newro0209/timing_belt_joint_module/docs/views/axle_printed_closeup.png

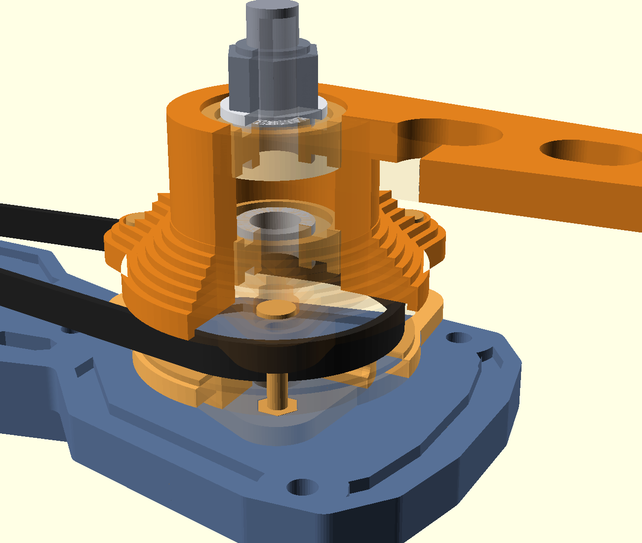
docs/views/axle_printed_closeup.png
