newro0209/timing_belt_joint_module/DESIGN.md

# 풀리 내장형 벨트 감속 관절 모듈 설계서

염가형 SCARA 로봇용 — NEMA 17 + GT2 6mm 벨트 감속 + 608ZZ 베어링 + 스트리퍼 볼트 회전축

---

## 1. 설계 개요

| 항목 | 사양 |
| --- | --- |
| 구동 모터 | NEMA 17 스테퍼, 5mm 축 |
| 입력축 풀리  | GT2 20T, 5mm bore, 6mm belt용 |
| 출력축 풀리  | GT2 60T, **8mm bore**, 6mm belt용 — Ø8 회전축에 직접 끼움 |
| 감속 방식 | GT2 2mm 피치 타이밍 벨트 1단 감속 |
| 감속비 | 3:1 |
| 회전축 | 스트리퍼 볼트, 쇼울더 Ø8 × L55 × M6 — 머리 하향, **암·풀리와 함께 회전** |
| 출력축 베어링 | 608ZZ, 8×22×7mm × 2개 — 베이스 일체 하향 보스에 **외륜 고정** |
| 스페이서 | 스케이트보드 베어링 스페이서 8×10×10mm × 1개 (내륜 사이) |
| 장력 조절 | 아이들러 없음 — 슬롯형 모터 마운트 + 잭 스크류 |
| 허브-풀리 결합 | M6 너트 축력으로 회전 적층에 통째로 클램프(마찰) + 풀리 보스 세트스크류 백업 |
| 제작 방식 | 프린팅 부품은 베이스/암 허브 2종(잭 블록은 베이스 일체), 금속 부품은 전량 기성품 무가공 사용 |

### 무가공 설계 원칙

이 설계는 드릴링·탭핑·선반 가공 없이 **3D 프린터와 일반 수공구만으로** 제작·조립할 수 있도록 다음 원칙을 따릅니다.

* 금속 기성품(모터, 풀리, 벨트, 베어링, 스트리퍼 볼트, 스페이서, 와셔, 볼트·너트류)은 구매 상태 그대로 사용하며 추가 가공을 하지 않습니다.
* 가공이 필요한 모든 형상(모터 슬롯, 보스 장공, 너트 포켓, 베어링 압입 포켓)은 3D 프린팅 부품의 형상에 미리 포함합니다.
* 프린팅 부품은 **베이스 플레이트(잭 스크류 블록 일체), 암 허브/암** 2종으로 한정합니다.
* 나사 체결은 ① 육각 너트 포켓, ② 관통 볼트 + 너트, ③ 모터 자체 탭(금속) 세 가지만 사용합니다. 플라스틱 직접 탭핑과 히트세트 인서트는 사용하지 않습니다.
* 금속 스페이서·와셔류는 3D 프린터/스케이트보드용으로 유통되는 표준품(스케이트 베어링 스페이서 8×10×10, M6/M8 평와셔, M3/M6 너트)만 사용합니다.

### 소재 절약 형상 — 3D 프린팅 ↔ CNC 공용 (2.5D)

초기 검증은 3D 프린팅으로, 이후 CNC 가공으로 전환하는 것을 전제로, 세 프린팅 부품 모두 **평면 윤곽 + 관통/단차 포켓만으로 구성된 2.5D 형상**을 유지하면서 다음과 같이 경량화했습니다. 동일 윤곽을 CNC(알루미늄/POM 판재)에서 그대로 재사용할 수 있습니다.

* **베이스 플레이트** — 직사각 통판 → **패싯(각면) 윤곽**: 45° 챔퍼 모터 패드 + 테이퍼 웨이스트 + 출력부 패싯 + 스웹트 윙(장착 귀). 상면에 패널라인 트렌치(깊이 2, 폭 3.5)와 웨이스트 헥스 벤트 2개(관통)를 넣어 강성 손실 없이 감량·스타일링. 프레임 장착홀은 모터 패드 1 + 웨이스트 1 + 윙 2의 4점.
* **웨이스트 보강** — 웨이스트 양 가장자리 하면에 보강 리브(4×6mm)를 따라 붙여 **C-채널 단면**으로 만들어 면외 굽힘 강성을 수 배 확보(윗면을 베드에 대고 출력하므로 서포트 불필요). 윤곽의 오목 꼭짓점은 R3 필렛으로 응력 집중을 완화. 알루미늄 CNC 가공 시에는 리브를 생략해도 충분합니다.
* **암** — 끝단 폭 32→18mm 테이퍼 + 관통 트러스 컷 3개(측벽 5mm 이상 유지).
* **암 허브** — 회전축 재설계로 베어링 보어·클램프 형상이 모두 빠져 Ø32×13 디스크 + 암만 남음. 베어링 하우징은 베이스 일체 하향 보스로 이동(부록 #14).

| 부품 (솔리드 기준) | 기존 | 최적화 | 절감 |
| --- | ---: | ---: | ---: |
| 베이스 플레이트 | 101.2cm³ | 60.7cm³ | −40% |
| 암 허브/암 | 32.5cm³ | 29.1cm³ | −10% |
| **합계** | **133.7cm³** | **89.8cm³** | **−33%** (PETG 솔리드 환산 170g→114g) |

(수치는 고정축 시절 기준 — 회전축 재설계로 허브가 디스크로 줄고 베이스에 보스가 더해져 합계는 더 줄었습니다.)

실제 출력 시에는 인필 30~50%를 적용하므로 사용량은 더 줄어듭니다. 단품 STL은 `scad/print_parts.scad`에서 내보냅니다.

**서포트 프리 출력** — 두 부품 모두 서포트 없이 출력되도록 형상을 맞췄습니다.

* 베이스: 윗면을 베드에. 잭 블록·**베어링 보스**·웨이스트 리브가 모두 같은 방향(하면 쪽)으로 자라고, 패널라인 트렌치는 3.5mm 브리지, 베어링 포켓 사이 웹은 1mm 링 브리지, 잭 너트 포켓은 꼭짓점-업 육각(60° 벽)이라 모두 서포트 불필요.
* 암 허브: 암 윗면을 베드에. 허브 디스크 Ø32 = 암 허브측 폭이라 오버행이 없는 평면 부품.

### 동작 원리 요약

스트리퍼 볼트를 **회전축**으로 사용합니다. 베어링 2개는 베이스 일체 하향 보스에 **외륜이 고정**되고, 볼트는 내륜을 관통해 자유롭게 회전합니다.

베이스 위로 올라온 Ø8 쇼울더에 출력 풀리(8mm bore)와 암 허브가 차례로 끼워지고, 적층 맨 위의 M6 나일록 너트를 조이면 「머리~내륜~풀리~허브~너트」 전체가 한 덩어리로 압축되어 **볼트·풀리·암이 함께 회전**합니다. NEMA 17 모터의 GT2 20T 풀리에서 벨트로 토크를 전달받습니다.

토크는 너트 축력에 의한 풀리~허브 면압 마찰로 전달되고, 풀리 보스의 세트스크류가 축을 직접 물어 백업합니다. 회전-고정 결합 부품(클램프 링, 콜릿 등)이 없으므로 벨트 z 구간의 회전체는 풀리뿐 — 어떤 회전각에서도 벨트 스팬과 간섭하지 않습니다.

### 축 방향 적층 구조 — 아래에서 위로

표준 스트리퍼 볼트의 M6 나사부는 **약 10mm로 고정**이므로, 볼트는 **머리를 아래로** 하여 베어링 보스 밑에서 위로 꽂고, **M6 너트를 적층 맨 위에서** 체결합니다. 베이스(보스)는 압축 경로에 들어가지 않습니다 — 베이스는 외륜만 잡고, 너트는 회전 적층만 조입니다.

1. **스트리퍼 볼트 머리 + 머리측 M8 평와셔 M8×15×1.6 (z −31.1~−24)** — 적층 최하단, 보스 하면 아래입니다. 머리가 와셔를 통해 하부 베어링 **내륜**을 누릅니다. 와셔 외경 15mm는 외륜(내경 Ø17.8)에 닿지 않습니다.

2. **하부 베어링 608ZZ (z −24~−17)** — 외륜은 보스 하면에서 압입, 내륜은 쇼울더와 함께 회전합니다.

3. **내륜 스페이서 — 스케이트 베어링 스페이서 8×10×10 × 1개 (z −17~−7)** — 상하 내륜 사이 간격 10mm 확보(베어링 중심 간 거리 17mm). 같은 구간의 외륜 사이에는 베이스의 내경 Ø20 웹이 있어 외륜을 양방향 축하중에 대해 받칩니다.

4. **상부 베어링 608ZZ (z −7~0)** — 외륜은 베이스 윗면에서 압입, 윗면과 면일치.

5. **중간 M8 평와셔 M8×15×1.6 (z 0~1.6)** — 상부 내륜과 풀리 사이의 다리. **생략 금지** — 없으면 풀리 보스 하면이 고정된 외륜에 닿아 관절이 잠깁니다.

6. **출력 풀리 GT2 60T, 8mm bore (z 1.6~17.3, 보스 하향)** — 쇼울더에 직접 끼워져 센터링. 보스 세트스크류(z≈4.85, 측면 접근)가 축을 물어 가고정/백업.

7. **암 허브 (z 17.3~30.3, 높이 13mm)** — Ø8.3 보어로 쇼울더에 끼워지고, 하면이 풀리 상부 플랜지를 누릅니다. 이 면압이 주 토크 경로입니다. 허브 높이 13mm가 적층 합(55.9mm)을 쇼울더(55mm)보다 길게 만들어, 너트가 쇼울더 단차가 아니라 **적층을 압축**하도록 보장합니다(심 와셔 불요 — 부록 #15).

8. **상부 광폭 평와셔 M6×22×2.0 + M6 나일록 너트 (z 30.3~38.3)** — 이 높이는 M6 나사부 구간이므로 내경 6.4의 M6 와셔를 씁니다. 외경 22mm가 너트 축력을 프린팅 허브 윗면에 넓게 분산합니다(면압 약 9MPa). 조이면 「너트 → 와셔 → 허브 → 풀리 → 중간 와셔 → 상부 내륜 → 스페이서 → 하부 내륜 → 머리측 와셔 → 머리」 순으로 **회전 적층 전체가 한 덩어리로 압축**됩니다.

베어링 예압·유격은 이 적층이 아니라 **내륜 스페이서(10mm) ↔ 외륜 웹 높이 차**로 결정됩니다(조립 순서 4 참조) — 적층 안에 조정용 심을 둘 이유가 없습니다.

#### 수지 계산 (쇼울더 L55 기준)

| 요소 | 높이 |
| --- | ----: |
| 머리측 M8 와셔 (15×1.6)  | 1.6mm |
| 하부 608ZZ 내륜 | 7mm |
| 내륜 스페이서 |  10mm |
| 상부 608ZZ 내륜 | 7mm |
| 중간 M8 와셔 (15×1.6) | 1.6mm |
| 출력 풀리 (보스 포함) | 15.7mm |
| 암 허브 |  13mm |
| 상부 M6 와셔 (22×2.0) | 2.0mm |
| **압축 적층 합계** | **57.9mm** |
| 쇼울더 길이 |  55mm |
| **클램프 여유** | **+2.9mm** |

적층 합계가 쇼울더 길이보다 **커야** 너트가 적층을 조일 수 있습니다. 여유 2.9mm는 나사부 10mm 안에서 너트(6mm)가 온전히 물리는 범위입니다(너트 z 32.3~38.3 vs 나사 29.4~39.4). 상부 와셔는 내경 6.4(M6)이므로 쇼울더 끝(z 29.4)이 허브 보어 안에 묻혀 있어야 하는데, 허브 상면(z 30.3)이 0.9mm 위에 있어 허브가 0.9mm 이상 낮게 출력되지 않는 한 만족됩니다. 압축 경로에 프린팅 허브(PETG)가 포함되므로 초기 며칠은 크리프 후 재조임을 권장합니다.

### 평면 배치 — 위에서 내려다본 구성

베이스 플레이트를 위에서 내려다보면, 한쪽에 NEMA 17 모터가, 반대쪽에 출력축(스트리퍼 볼트 + 암)이 배치되고 두 축의 중심 간 거리는 약 99mm입니다.

* **모터 측** — NEMA 17이 슬롯 4개(M3용 장공)를 통해 베이스 하면에 매달려 체결되며, 모터 축에는 GT2 20T 입력 풀리가 장착됩니다. 슬롯의 장축 방향은 두 풀리 중심을 잇는 선과 평행하므로, 모터를 슬롯 방향으로 밀고 당겨 벨트 장력을 조절할 수 있습니다.
* **잭 스크류** — 모터 **앞쪽(출력 풀리 쪽)**, 베이스 **하면**에 잭 스크류 블록이 있습니다. 모터 몸체가 베이스 아래에 매달려 있으므로 블록도 같은 높이에 있어야 하며, M3 스크류 끝이 모터 앞면을 **출력 풀리 반대쪽으로 밀어** 축간거리를 늘려 장력을 거는 구조입니다.
* **출력축 측** — 베이스의 하향 베어링 보스 안에서 스트리퍼 볼트가 회전하며, 볼트에 클램프된 GT2 60T 출력 풀리가 폐루프 GT2 벨트(6mm 폭)로 20T 입력 풀리와 연결됩니다. 암은 풀리·볼트와 한 몸으로 회전하여 베이스 바깥쪽으로 뻗어 나갑니다.

### 조립 모델 색 규약

`scad/` 조립 모델과 렌더 이미지는 **회전부를 주황 계열, 고정부를 블루/그레이 계열**로 구분합니다.

* 주황/웜(회전) — 암 허브/암, 출력 풀리, 스트리퍼 볼트, 베어링 **내륜**, 내륜 스페이서, 와셔·너트, 입력 풀리, 모터 축
* 블루/그레이(고정) — 베이스 플레이트(+베어링 보스), 베어링 **외륜**·실드, 모터 몸체, 모터 체결 볼트, 잭 스크류
* 회전 축 계통은 웜 **톤온톤**으로 세분: 너트(진함) < 축 < 내륜 < 스페이서 < 평와셔(밝음)
* 조립 렌더의 1/4 사분면은 잘라내지 않고 **반투명 고스트**로 표시합니다(부품별 투명도 차등 — 겉을 감싸는 큰 부품일수록 투명). `assembly.scad`의 `ghost_alpha` 및 `cutaway()`의 `ga` 인자로 조절.

베어링이 두 색으로 갈리는 것이 이 관절의 핵심입니다 — **내륜 계통이 너트로 압축된 회전 적층**이고, 외륜은 베이스 보스에 고정됩니다.

---

## 2. 감속비 / 풀리 치수 조합

GT2 2mm 피치 기준 피치원 지름은 다음과 같습니다.

```text
PD = 잇수 × 2 / π
```

| 항목 | 값 |
| --- | ---: |
| 입력 풀리 | GT2 20T, 5mm bore |
| 입력 풀리 PD  | 약 12.7mm |
| 출력 풀리 | GT2 60T, 8mm bore |
| 출력 풀리 PD  | 약 38.2mm |
| 감속비 | 3:1 |
| 권장 벨트 |  GT2-280mm, 6mm 폭 |
| 권장 축간거리 C | 약 99.2mm |
| 소풀리 감김각 | 약 165° |
| 소풀리 물림 잇수 | 약 9.2개 |

### 권장 조합

| 조합 | 감속비 | 모터 풀리 | 출력 풀리 | 권장 벨트 | 축간거리 C | 소풀리 감김각 / 물림 잇수 |
| --- | --: | --- | --- | --- | ---: | ---: |
| 기본 조합  | 3:1 | GT2 20T, 5mm bore | GT2 60T, 8mm bore | GT2-280-6mm |  약 99.2mm | 약 165° / 9.2개 |
| 준컴팩트 조합 | 3:1 | GT2 20T | GT2 60T | GT2-260-6mm |  약 89.1mm | 약 164° / 9.1개 |
| 컴팩트 조합 | 3:1 | GT2 20T | GT2 60T | GT2-200-6mm |  약 58.6mm | 약 155° / 8.6개 |
| 여유 조합  | 3:1 | GT2 20T | GT2 60T | GT2-300-6mm | 약 109.3mm | 약 167° / 9.3개 |

**권장값은 GT2-280-6mm 벨트 + 축간거리 약 99mm**입니다.

버전 전환은 `scad/params.scad`의 `belt_len`(200/260/280/300)으로 하며, 축간거리 C는 벨트 길이식 2C + π(D+d)/2 + (D−d)²/4C = L 의 역산으로 자동 결정됩니다. **GT2-200 컴팩트**(C≈58.6)는 베이스가 웨이스트 없는 단축 윤곽으로 전환됩니다 — 모터 패드가 윙에 직결되고, 프레임 장착홀 3점(웨이스트 홀 제외), 웨이스트 리브·헥스 벤트는 생략됩니다.

GT2-150은 **성립하지 않습니다** — C≈32.5mm가 되는데, 베이스 아래 같은 높이에 있는 NEMA 17 몸체(반폭 21.15)와 베어링 보스(반경 16)의 최소 축간거리가 약 37.2mm라 4.7mm 간섭합니다. 150급 길이가 필요하면 출력 40T(2:1, C≈44.5) 또는 소형 모터로의 변경이 전제됩니다.

슬롯 조절 범위 ±5mm를 확보하면(슬롯 길이 14mm) 벨트 길이 오차와 제작 오차를 충분히 흡수할 수 있습니다.

### 출력 토크 및 분해능

NEMA 17 홀딩토크를 0.45N·m로 가정하면 다음과 같습니다.

```text
출력 홀딩토크 ≈ 0.45 × 3 × 0.95 ≈ 1.28N·m
```

| 항목 | 값 |
| --- | ---: |
| 감속비 | 3:1 |
| 출력 홀딩토크 | 약 1.28N·m |
| 풀스텝 출력 분해능 | 1.8° / 3 = 0.6° |
| 16 마이크로스텝 기준 | 0.6° / 16 = 0.0375° |

GT2 6mm 벨트와 3:1 감속 구조는 **소형 SCARA의 팔꿈치 J2, 손목축, 경량 어깨축**에 적합합니다. 어깨 J1처럼 큰 모멘트를 받는 축에는 벨트 폭 9mm 이상 또는 2단 감속을 검토하는 편이 좋습니다.

---

## 3. 슬롯형 모터 고정 구조

### 구조

베이스 플레이트를 3D 프린팅하며, 다음 형상을 모두 프린팅 형상에 포함합니다. 후가공은 하지 않습니다. 잭 블록이 베이스 하면에 돌출되므로 **베이스는 윗면을 베드에 대고** 프린팅하면 서포트가 필요 없습니다.

모든 슬롯의 장축 방향은 **두 풀리 중심을 잇는 선과 평행**해야 합니다.

1. **모터 체결 슬롯 4개**

   * M3 볼트용
   * 폭 3.4mm
   * 길이 14mm (조절 범위 ±5.3mm)
   * NEMA 17의 31mm 정사각 체결 패턴 기준

2. **센터 보스 장공 1개**

   * NEMA 17 전면 Ø22 위치결정 보스용
   * 폭 22.5mm
   * 길이 34.5mm 오벌 형상

3. **잭 스크류 블록 (베이스 일체)**

   * 모터 **앞쪽(출력 풀리 쪽)**, **베이스 하면**에 배치 — 모터 몸체가 베이스 아래에 매달리므로 미는 지점도 베이스 아래(스크류 축 약 z−15mm)에 있어야 합니다.
   * 프린팅 블록에 M3 육각 너트 포켓을 몰드-인 — 포켓은 모터 쪽(−x) 면에 두어, 스크류가 모터를 밀 때 너트가 블록 살에 받쳐지게 합니다.
   * M3×20 스크류 끝이 모터 앞면을 출력 풀리 반대쪽으로 밀도록 설계. 머리는 출력축 쪽을 향하므로 베이스 아래 공간에서 드라이버로 돌립니다.

### 장력 조절 절차

1. 모터 체결 볼트 4개를 살짝만 조인 상태로 벨트를 겁니다.
2. 잭 스크류를 돌려 모터를 출력 풀리 반대쪽으로 밀어 장력을 겁니다.
3. 장력을 확인한 뒤 모터 볼트 4개를 대각선 순서로 본조임합니다.
4. 잭 스크류는 그대로 두어 장력 저하 방지 스토퍼로 사용합니다.

### 적정 장력 기준

* 스팬 중앙을 손가락으로 눌렀을 때 **벨트 폭 정도, 즉 약 5~6mm 처짐**이면 적정입니다.
* GT2 6mm 벨트는 과장력을 주지 않는 것이 중요합니다.
* 백래시 제거에 필요한 최소 장력만 주는 방향이 좋습니다.
* NEMA 17 축에 불필요한 레이디얼 하중이 걸리지 않도록 편측 장력은 보수적으로 관리합니다.

---

## 4. 회전축 — Ø8 스트리퍼 볼트 + 608ZZ 베어링 구조

### 부품 선정

| 항목 | 규격 | 비고 |
| --- | --- | --- |
| 스트리퍼 볼트 | 쇼울더 Ø8 × L55 × M6 (나사부 10mm) | 국내명 쇼울더볼트 또는 스트리퍼볼트, 머리 하향 — **회전축으로 사용** |
| 베어링 | 608ZZ, 8×22×7mm × 2 | 구하기 쉬운 표준 베어링(스케이트보드용), 외륜을 베이스 보스에 압입 |
| 스페이서 | 스케이트 베어링 스페이서 8×10×10mm × 1 | 내륜 사이, 스케이트보드 표준품 |
| 평와셔 | M8×15×1.6 × 2, M6×22×2.0 × 1 | 머리측·중간(M8, 외륜 간섭 금지) + 상부 광폭(M6, 허브 면압 분산) |
| 너트 | M6 나일록 너트 × 1 | 적층 상단 체결 (회전 적층 전체를 클램프) |

(이전의 고정축 구조와 `hub_mount` 콜릿/세트스크류 결합 변형은 회전축 재설계로 제거했습니다 — git 히스토리 참조. 변형 분기 없는 단일 구조입니다.)

### 회전 원리

* 베이스의 **하향 베어링 보스**(Ø32, z −25~−8)에 608ZZ 2개의 **외륜**을 압입합니다 — 상부는 베이스 판 두께 안(z −7~0), 하부는 보스 안(z −24~−17), 사이의 내경 Ø20 웹이 외륜을 양방향 축하중에 대해 받칩니다.
* 스트리퍼 볼트는 **머리를 아래로** 하여 보스 밑에서 위로 꽂습니다. Ø8 쇼울더가 두 베어링 내륜을 지나 베이스 위로 올라오고, 풀리(8mm bore)와 허브가 쇼울더에 차례로 끼워집니다.
* 위쪽 M6 나사부(10mm)에 광폭 M6 와셔(22×2.0)를 끼우고 M6 나일록 너트로 본조임하면, 「머리 → 와셔 → 하부 내륜 → 스페이서 → 상부 내륜 → 와셔 → 풀리 → 허브 → 와셔 → 너트」 가 한 덩어리로 압축되어 **볼트·내륜·풀리·허브·암 전체가 함께 회전**합니다.
* 토크는 너트 축력에 의한 면압 마찰(풀리 상부 플랜지 ↔ 허브 하면)로 전달되고, 풀리 보스의 **세트스크류가 Ø8 축을 직접 물어** 백업 + 조립 가고정을 겸합니다.

### 베이스 베어링 포켓 설계

| 항목 | 권장값 |
| --- | ---: |
| 베어링 외경 | 22mm |
| 프린팅 포켓 — 후가공 없음 | 21.8~22.0mm, 공차 시험편으로 프린터별 보정 |
| 최종 압입 목표 | 약 22.0mm 근처 |
| 외륜 웹 내경 | 20mm |
| 베어링 간 중심 거리 | 내륜 스페이서 10mm + 7mm = 17mm |

**압입 방향:** 상부 베어링은 베이스 윗면에서 아래로(웹 상면 z −7에 닿을 때까지), 하부 베어링은 보스 하면에서 위로(웹 하면 z −17) 압입합니다. 내륜 스페이서는 두 베어링을 넣기 **전에** 웹 안쪽에 넣어 둡니다(웹 내경 Ø20 < 베어링 외경이므로 나중에 넣을 수 없습니다).

---

## 5. 출력 풀리 ↔ 암 결합 — 회전 적층 클램프

출력 풀리는 **GT2 60T, 8mm bore, 6mm belt용** 기성품을 **무가공 그대로** 사용합니다. 8mm bore가 Ø8 쇼울더에 직접 끼워져 센터링되므로, 별도 결합 부품이 필요 없습니다.

### 왜 회전축인가 — 결합 부품의 소거

고정축 구조에서는 "회전하는 풀리·허브"를 "회전하는 베어링 외륜"에 묶기 위한 결합 수단(클램프 링, 콜릿 슬리브, 핀치 볼트 등)이 반드시 필요했고, 그 결합부가 벨트 스팬과의 간섭(부록 #13)이나 부품 수 증가를 낳았습니다.

축 자체가 회전하면 결합 문제가 통째로 사라집니다 — 회전해야 하는 모든 부품(내륜·풀리·허브)을 **스트리퍼 볼트의 머리~너트 사이에 축 방향으로 한 번에 클램프**하면 끝입니다. 베어링은 베이스 일체 하향 보스에 들어가 정통적인 "회전축 + 고정 하우징" 배치가 되고, 내륜 회전·외륜 고정이라는 베어링 본래 사용법과도 일치합니다.

* **삭제된 부품**: 스탠드오프 스페이서 ×2, 클램프 링/콜릿 체결구 일체, 허브의 베어링 보어·슬리브, 심 와셔(부록 #15)
* **변경**: 출력 풀리 bore 12 → **8mm**(더 흔한 규격), 평와셔 2 → 3개(위치별 규격)
* **허브**: 베어링 없는 단순 디스크(Ø32×13) + 암 — 가장 만들기 쉬운 형태

### 토크 전달

1. **주경로 — 면압 마찰**: M6 너트 축력(약 3kN)이 「허브 하면 ↔ 풀리 상부 플랜지」 면을 누릅니다. 마찰 토크는 출력 홀딩토크 1.3N·m 대비 수 배 여유입니다.
2. **백업 — 보스 세트스크류**: 풀리 보스(하향, z 1.6~8.1, 측면 접근 가능)의 세트스크류가 Ø8 쇼울더를 직접 뭅니다. 조립 중 가고정을 겸하며, 쇼울더 표면이 경질이므로 나사고정제 병용을 권장합니다.
3. 벨트 z 구간(9.7~15.7)의 회전체는 풀리뿐(반경 ≤22), 베이스 위 고정물은 없음 — **가동 범위 360°, 벨트 간섭 원천 차단**.

### 대안 — 풀리 웹 드릴링 직결 (드릴 가공이 가능한 환경에서만)

GT2 60T 풀리의 웹에 M3 관통홀을 뚫어 허브에 볼트 직결하면 마찰 의존을 없앨 수 있으나, 금속 드릴링이 필요하므로 무가공 원칙을 지키는 본 설계에서는 채택하지 않습니다. 미끄럼이 관측되면 먼저 너트 토크를 점검하고, 그래도 부족할 때 검토합니다.

---

## 6. 부품 리스트 — 관절 1개 기준

| #  | 부품 | 규격 |  수량 | 비고 |
| -- | --- | ---: | --: | --- |
| 1  | 스테퍼 모터 | NEMA 17, 5mm 축 | 1 | 17HS4401 등  |
| 2  | 입력 풀리 | GT2 20T, 5mm bore, 6mm belt용 | 1 | 플랜지 포함 권장 |
| 3  | 출력 풀리 | GT2 60T, **8mm bore**, 6mm belt용 | 1 | Ø8 쇼울더에 직접 끼움, 무가공, 보스 하향 |
| 4  | 타이밍 벨트 | GT2 폐루프, 6mm 폭, 280mm 권장 | 1 | 축간거리 약 99mm |
| 5  | 스트리퍼 볼트 | 쇼울더 Ø8 × L55 × M6(나사부 10mm) | 1 | **회전축**, 머리 하향  |
| 6  | 베어링 | 608ZZ, 8×22×7mm | 2 | 베이스 보스에 외륜 압입, 상하 배치 |
| 7  | 내륜 스페이서 | 스케이트 베어링 스페이서 8×10×10 | 1 | 스케이트보드 표준품  |
| 8  | — (결번) |  |  | 스탠드오프 폐지 — 회전축 재설계 (부록 #14) |
| 9  | — (결번) | | | 심 와셔 폐지 — 허브 13mm 증육 + 광폭 와셔 (부록 #15) |
| 10 | 평와셔 |  M8×15×1.6 ×2 + M6×22×2.0 ×1 | 3 | 머리측·중간(M8, 외륜 간섭 금지) + 상부 광폭(M6) |
| 11 | 모터 체결 볼트 | M3×12 캡볼트 + M3 대형와셔 | 4 | 베이스 8 + 와셔 1 통과 후 모터 탭 3mm 물림 |
| 12 | — (결번) |  |  | 클램프 계통 폐지 — 회전축 재설계 (부록 #13·14) |
| 13 | M3 육각 너트 | M3 | 1 | 잭 블록 포켓 |
| 14 | 잭 스크류 | M3×20 | 1 | 너트는 #13에 포함  |
| 15 | 베이스 플레이트 | PETG/ABS/ASA 프린팅, 8mm 이상 | 1 | 슬롯·장공·잭 블록·**베어링 보스**·너트 포켓 일체 |
| 16 | 암 허브/암 | 프린팅, Ø32 디스크 + 암, Ø8.3 보어 | 1 | 회전 적층에 클램프 |
| 17 | — (결번) |  |  | 클램프 링 폐지 (부록 #13) |
| 18 | M6 나일록 너트  | M6 | 1 | 적층 상단 체결 — 회전 적층 전체를 클램프 (와셔는 #10) |

---

## 7. 조립 순서

1. **베이스 준비 + 베어링 압입**

   * 베어링 보스(하향)·포켓, NEMA 17 모터 슬롯, Ø22 보스 장공, 하면 잭 블록 + 너트 포켓, 프레임 장착홀을 모두 형상에 포함하여 베이스를 프린팅합니다(윗면을 베드에).
   * 후가공 없이 서포트 제거와 구멍 정리만 합니다. 잭 스크류용 M3 너트를 블록 포켓에 삽입합니다.
   * **내륜 스페이서를 웹 안에 먼저 넣고**, 상부 608ZZ는 베이스 윗면에서, 하부 608ZZ는 보스 하면에서 각각 웹에 닿을 때까지 압입합니다(외륜만 누를 것).

2. **모터 장착 + 모터 풀리**

   * 모터를 베이스 아래에 대고 M3×12 볼트 + 대형 와셔 4개로 살짝만 체결합니다(슬롯 중앙 부근).
   * GT2 20T 풀리를 보스가 아래로 가게 모터 축에 끼우고, 세트스크류 하나가 D컷 면을 누르도록 배치합니다. 높이는 출력 풀리와 벨트 중심이 맞도록(이빨부가 베이스 윗면 기준 약 8.9~16.5mm) 조정합니다.

3. **회전축 적층 조립**

   * 스트리퍼 볼트에 머리측 M8 와셔를 끼우고 **보스 하면에서 위로** 꽂습니다. 내륜 스페이서 구멍이 어긋나 걸리면 축을 살짝 돌려 정렬합니다.
   * 베이스 위로 올라온 쇼울더에 중간 M8 와셔를 끼웁니다.
   * 출력 풀리(8mm bore, 보스 아래로)를 쇼울더에 끼우고, **벨트를 풀리에 미리 걸쳐 둡니다**(폐루프 벨트는 암 장착 후 넘겨 끼울 수 없습니다). 보스 세트스크류를 살짝만 조여 가고정합니다.
   * 암 허브를 쇼울더에 끼우고, 광폭 M6 와셔(22×2.0)를 올린 뒤 M6 나일록 너트로 본조임합니다 — 이 축력이 내륜·풀리·허브를 한 덩어리로 묶습니다.
   * 마지막으로 보스 세트스크류를 본조임합니다(나사고정제 권장).

4. **회전 확인**

   * 암이 걸림 없이 부드럽게 회전하는지 확인합니다.
   * 뻑뻑하면 내륜 스페이서(10mm)와 외륜 웹의 높이 불일치로 베어링에 과예압이 걸린 상태입니다 — 웹을 9.8mm 수준으로 살짝 낮게 프린팅해 미세 유격 쪽으로 맞춥니다.
   * 암이 축째로 덜렁거리면 너트 본조임이 덜 된 것입니다 — 허브 상면이 쇼울더 끝(z 29.4)보다 위에 있는지(허브 높이 수지 +0.9mm) 확인하고 다시 조입니다. 암만 헛돌면 허브~풀리 면압 부족이므로 너트 토크를 올립니다.

5. **벨트 장력 조절**

   * 잭 스크류를 돌려 모터를 출력 풀리 반대쪽으로 밀어 장력을 줍니다.
   * 모터 고정 볼트 4개를 대각선 순서로 본조임합니다.

6. **벨트 트래킹 확인**

   * 저속 왕복 구동하면서 벨트가 한쪽 플랜지로 과하게 쏠리지 않는지 확인합니다.
   * 쏠림이 있으면 모터 풀리 높이, 모터 마운트 직각도를 수정합니다.

---

## 8. 설계 시 주의사항

1. **출력 풀리 세트스크류는 이제 축을 물어야 함**

   * 이 구조에서 Ø8 스트리퍼 볼트는 풀리·허브와 **함께 회전하는 축**입니다. 세트스크류가 축을 물어도 관절이 잠기지 않습니다 — 오히려 토크 백업 + 조립 가고정으로 **사용합니다**.
   * 쇼울더 표면이 매끈하고 경질이라 세트스크류 단독 그립은 약합니다. 주 토크 경로는 너트 축력 면압이며, 세트스크류에는 나사고정제를 권장합니다.

2. **풀리 bore는 8mm — 축에 직접 끼움**

   * 8mm bore가 Ø8 쇼울더에 슬라이드 끼움되어 풀리 센터링을 겸합니다.
   * 12mm bore 풀리를 쓰면 센터링이 사라지므로 사용하지 않습니다(8mm bore가 시판 60T의 가장 흔한 규격입니다).

3. **스트리퍼 볼트 방향과 나사 길이**

   * 표준 쇼울더볼트의 M6 나사부는 약 10mm 고정입니다. 회전 적층 합계(약 57.9mm)가 쇼울더(55mm)를 넘어야 너트가 적층을 압축합니다 — 허브 13mm 증육이 이 수지(+0.9mm, 와셔 포함 +2.9mm)를 만듭니다. 머리 하향 + 상단 너트 배치를 유지합니다.
   * 머리측·중간 M8 와셔는 수지 계산에 포함되므로 생략 금지. 특히 **중간 와셔(상부 내륜~풀리 사이)** 가 없으면 풀리 보스 하면이 고정된 외륜에 닿아 관절이 잠깁니다.
   * 상부 와셔는 광폭 M6×22×2.0을 사용합니다 — 외경이 작은 와셔(또는 심)를 쓰면 너트 축력이 좁은 면적으로 프린팅 허브를 파고들어 크리프로 예압이 빠집니다(부록 #15).

4. **베어링 압입 방향 (베이스 보스)**

   * 상부 포켓은 베이스 윗면으로, 하부 포켓은 보스 하면으로 개방되어 있습니다. 양쪽이 모두 막힌 포켓은 조립이 불가능하므로, 베이스 형상 수정 시 주의합니다.
   * 내륜 스페이서는 베어링 압입 **전에** 웹 안에 넣습니다(웹 내경 Ø20 < 베어링 외경).

5. **608ZZ는 구하기 쉽지만 정밀 관절용 베어링은 아님**

   * 경량 SCARA에는 사용할 수 있으나, 긴 암과 큰 하중에는 베어링 간격을 충분히 확보해야 합니다. 본 설계의 베어링 중심 간 거리는 17mm입니다.

6. **GT2 6mm 벨트의 한계**

   * 6mm 벨트는 소형·경량 구조에 적합합니다.
   * 어깨축처럼 큰 토크와 모멘트가 걸리는 곳에는 9mm 이상 벨트 또는 2단 감속이 유리합니다.

7. **벨트 평면 일치**

   * 입력 풀리와 출력 풀리의 벨트 중심 높이 차는 0.5mm 이내로 맞추는 것이 좋습니다(본 설계 기준 벨트 구간 z 9.7~15.7mm).
   * 20T 풀리 이빨부 상단(z≈16.5)이 모터 축 끝(축 길이 22mm 기준 z≈14) 위로 약간 나오지만, 풀리 강성으로 문제없습니다. 축이 짧은 모터는 풀리를 끝까지 올려 장착합니다.

8. **3D 프린팅 크리프**

   * 모터 슬롯부에는 반드시 대형 와셔를 사용합니다.
   * PLA보다는 PETG, ABS, ASA를 권장합니다.
   * 모터 마운트 주변은 두께 8mm 이상, 인필 50% 이상으로 프린팅하여 크리프에 의한 장력 저하를 줄입니다.
   * 잭 스크류를 장력 스토퍼로 남겨 두면 슬롯부 크리프가 생겨도 장력이 유지됩니다.

9. **벨트는 분해 없이 교체 불가**

   * 폐루프 벨트는 암을 넘어 끼울 수 없으므로, 교체 시 M6 너트를 풀고 암 허브만 들어냅니다(베어링·축은 그대로 — 고정축 구조보다 간단, 약 2~3분 작업).

---

## 9. 다음 단계 제안

* [ ] 608ZZ 베이스 포켓 압입 공차 시험편 출력 (Ø21.8/21.9/22.0)
* [ ] 외륜 웹 높이 보정 — 내륜 스페이서 10mm 대비 9.8mm 수준으로 미세 유격 확인
* [ ] 너트 토크 ↔ 허브-풀리 미끄럼 시험 (크리프 후 재조임 포함)
* [ ] 8mm bore 60T 풀리의 보스 치수·세트스크류 규격 실측 확인
* [ ] 쇼울더 L55 수급 확인, 불가 시 부분나사 M8×60 대안 검증
* [ ] J1 적용 시 벨트 폭 9mm 이상 또는 2단 감속 구조 검토
* [ ] CNC 전환: 동일 2.5D 윤곽으로 알루미늄/POM 판재 가공 (베이스 t8), 베어링 포켓은 리머 H7 공차로 격상

---

## 부록 — 검증에서 발견되어 수정된 문제 (2026-06)

| # | 문제 | 수정 |
| - | ---- | ---- |
| 1 | 표준 쇼울더볼트 M6 나사부는 10mm뿐이라, 머리 상향 배치로는 베이스 아래로 나사가 0.6~2mm만 나와 너트 체결 불가 | 머리 하향 + 상단 M6 나일록 체결로 반전, 쇼울더 L55 + 수지 계산표 추가 |
| 2 | 허브 상부 베어링 보어가 위(Ø20 립)·아래(Ø20 웹) 모두 막혀 있어 베어링 삽입 불가 | 상부 보어를 허브 윗면까지 개방, 압입 방향 명기 |
| 3 | 실물 GT2 60T의 세트스크류 보스(Ø32×6.5, 전체 높이 ~16mm)가 반영되지 않아 평판 샌드위치 전제가 깨지고, 모델상 풀리가 허브 본체와 체적 간섭 | 풀리를 보스 하향으로 허브 아래에 배치, 적층을 재설계(스탠드오프 20mm) |
| 4 | Ø10 센터링 보스는 벽 두께 0.7mm로 프린팅 불가·강도 없음 | 허브 하면 Ø44.6 플랜지 받이 포켓으로 센터링 방식 변경, bore 10→12mm(스페이서 통과) |
| 5 | 잭 스크류가 모터 뒤에서 +x로 밀어 축간거리가 줄어드는(벨트가 풀리는) 방향이었고, 높이도 베이스 위(z+7)라 베이스 아래에 매달린 모터(z−8~−48)에 닿지 않음 | 블록을 모터 앞쪽·베이스 하면(z−15)으로 이동, 미는 방향을 출력 풀리 반대쪽으로 수정 |
| 6 | 모터 볼트 M3×8은 베이스 8mm + 와셔 1mm를 통과하면 모터 탭에 전혀 물리지 않음 | M3×12로 변경(물림 약 3mm) |
| 7 | 클램프 체결에 히트세트 인서트와 너트가 동일 볼트에 중복 지정, 허브 플랜지 2.2mm는 인서트 길이(4mm)를 수용 불가 | 인서트 폐기, 클램프 링 윗면 너트 포켓 방식으로 단일화, 플랜지 4mm로 증육 |
| 8 | 베이스 축 구멍 Ø6.5는 Ø8 쇼울더 통과 불가(모델상 0.75mm 간섭) | Ø8.3으로 확대 — 축 위치 결정 겸용 |
| 9 | 스페이서 "외경 10~12, 길이 8~10"은 비표준 치수 조합 | 스케이트 베어링 스페이서 8×10×10 표준품 3개로 통일 |
| 10 | 슬롯 길이 12mm는 문서의 ±5mm 조절 범위와 불일치(±4.3mm) | 슬롯 14mm로 연장 |
| 11 | 60T 이빨 외경 40.4mm는 과대(실제 PD 38.2 − 0.5 ≈ 37.7) | 37.7mm로 수정, 벨트 경로 동기화 |
| 12 | 베이스에 프레임 장착 수단 없음 | 모서리 M4 관통홀 4개 추가 |
| 13 | 클램프 볼트(PCD50, 반경 23.5~26.5)가 벨트 직선 스팬(수직거리 18.85~20.35)을 벨트 높이에서 가로질러, 회전 약 ±36° 이후 충돌 — 가동 범위 치명 제한 | 풀리를 보스 상향으로 반전, 허브 슬리브 직결(`hub_mount` 콜릿/세트스크류 2변형)로 1차 재설계, 클램프 링·PCD50 볼트 폐지 |
| 14 | 고정축 구조에서는 회전부-외륜 결합 부품(슬리브·콜릿·체결구)이 필수이고 풀리가 허브에 캔틸레버로 매달림 | **회전축 구조로 전면 재설계** — 베어링 외륜을 베이스 일체 하향 보스에 고정, 볼트+내륜+풀리(8mm bore)+허브를 M6 너트 축력으로 통째 클램프. 스탠드오프 ×2·결합 변형 일체 삭제, 허브는 Ø32 디스크로 단순화, 가동 360° 유지 |
| 15 | 심 와셔(Ø14)가 너트 축력을 평와셔(Ø16)보다 좁은 면적으로 프린팅 허브에 전달 — 전단 가공 모서리가 수지면을 파고들어 크리프·예압 손실. 심은 직렬 적층이라 베어링 예압 조정 기능도 실제로는 없음(예압은 스페이서↔웹 높이 차로 결정) | 심 와셔 폐지 — 허브 12→13mm 증육으로 「적층 > 쇼울더」 수지를 형상으로 보장(+0.9mm), 상부 와셔를 광폭 M6×22×2.0으로 변경해 허브 면압 약 30→9MPa로 저감. 평와셔는 위치별 기성품(M8×15×1.6 ×2 + M6×22×2.0 ×1)으로 확정 |
