newro0209/timing_belt_joint_module/docs/views/axle_collar.png

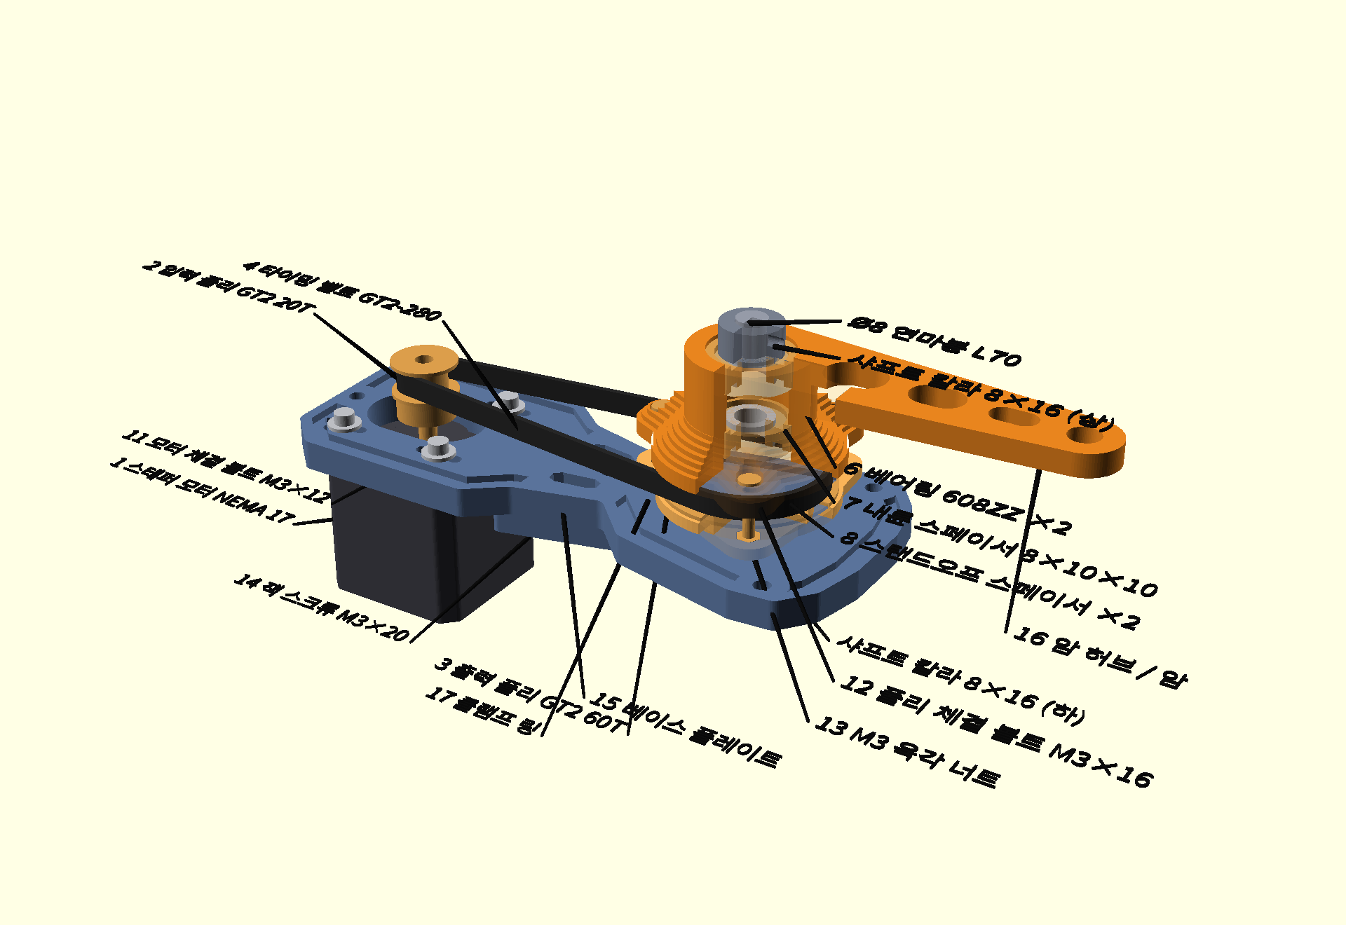
docs/views/axle_collar.png
