newro0209/timing_belt_joint_module/docs/views/bottom.png

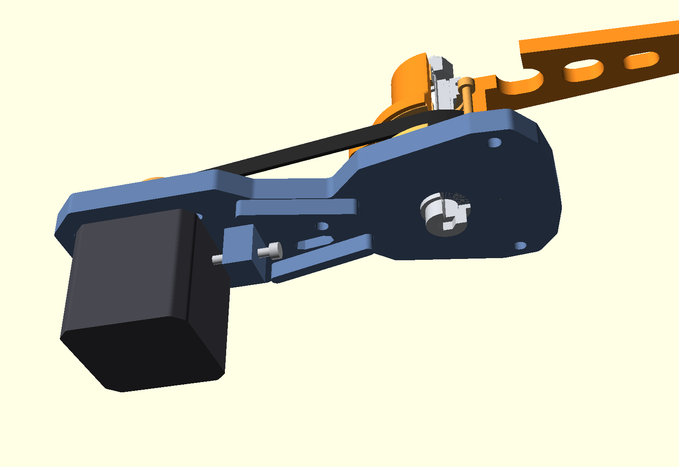
docs/views/bottom.png
