newro0209/timing_belt_joint_module/docs/views/iso_rear.png

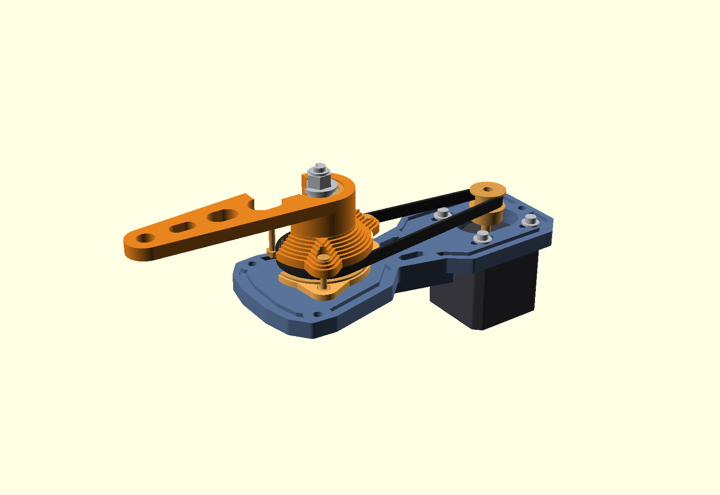
docs/views/iso_rear.png
