newro0209/timing_belt_joint_module/docs/views/side.png

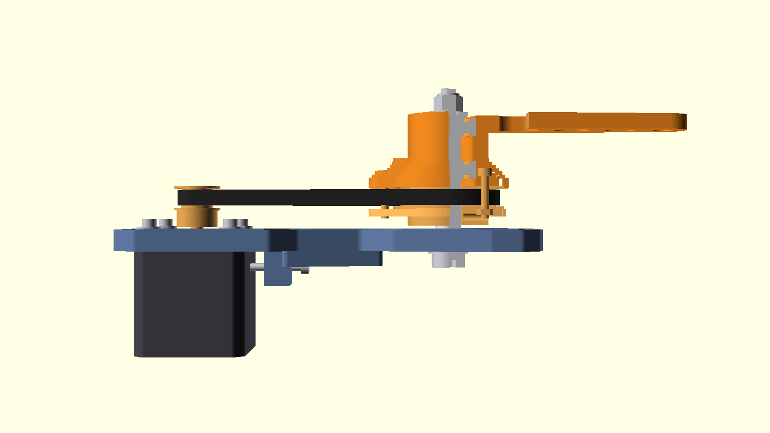
docs/views/side.png
