newro0209/timing_belt_joint_module/docs/views/top.png

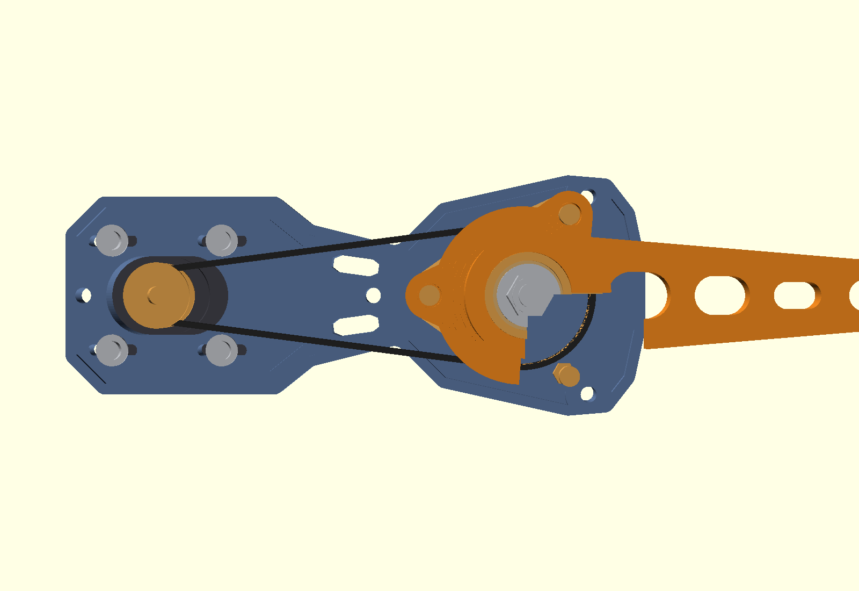
docs/views/top.png
