newro0209/timing_belt_joint_module/scad/motor_side.scad

include <params.scad>

// =====================================================
// 모터 측 + 베이스 부품 모듈
// 모든 모듈은 전역 좌표계에 이미 배치된 상태로 그림
//  - 베이스 윗면 z=0, 출력축 중심 (0,0), 모터축 중심 (-axis_dist, 0)
// =====================================================

// ---- 내부 헬퍼: x방향 장공 2D (폭 w, 전체 길이 l, 끝 둥글게) ----
module _slot2d_x(w, l) {
    hull() {
        translate([-(l - w) / 2, 0]) circle(d = w);
        translate([ (l - w) / 2, 0]) circle(d = w);
    }
}

// ---- 베이스 윤곽 2D — 패싯(각면) 스타일, 소재 절약 + CNC 2.5D 호환 ----
// 모터 패드(45° 챔퍼) → 테이퍼 웨이스트 → 출력부 패싯 + 스웹트 윙(장착 귀)
// 모터 패드는 모터 중심(-axis_dist) 상대 좌표 — belt_len에 따라 함께 이동.
// compact_base(C<81)면 웨이스트를 생략하고 패드가 윙에 직결된다.
_m = -axis_dist;
_pad_bot   = [[_m - 28.8, -18], [_m - 18.8, -28], [_m + 31.2, -28]];
_pad_chamf = [[_m + 41.2, -20]];                    // 패드 → 웨이스트 챔퍼 (full 전용)
_waist_bot = [[-34, -14], [-22, -26]];              // 웨이스트 → 윙 진입
_wing      = [[14, -34], [26, -33], [33, -24],      // 스웹트 윙 (아래)
              [36, -10], [36, 10],                  // 전면 패싯
              [33, 24], [26, 33], [14, 34]];        // 스웹트 윙 (위)
_waist_top = [[-22, 26], [-34, 14]];
_pad_chamf_t = [[_m + 41.2, 20]];
_pad_top   = [[_m + 31.2, 28], [_m - 18.8, 28], [_m - 28.8, 18]];

_base_pts = compact_base
    ? concat(_pad_bot, _wing, _pad_top)
    : concat(_pad_bot, _pad_chamf, _waist_bot, _wing, _waist_top, _pad_chamf_t, _pad_top);

module _base_poly2d() { polygon(_base_pts); }

module _base_outline2d() {
    // 볼록 꼭짓점 R3 + 오목 꼭짓점 R3 (응력 집중 완화, CNC 공구 반경)
    offset(r = 3) offset(r = -6) offset(r = 3) _base_poly2d();
}

// 웨이스트 보강 리브 중심선 — 윤곽 경사 에지를 따라 인셋 2.5
// (베이스 하면에서 아래로 돌출, C-채널 단면화. CNC 가공 시 생략 가능)
rib_x0 = -62; rib_x1 = -28;
function _waist_edge_y(x) = 20 - 0.25 * (x + 58);   // 패드(-58,20)→(-34,14) 에지

module _waist_ribs() {
    for (s = [-1, 1]) {
        y0 = s * (_waist_edge_y(rib_x0) - 2.5);
        y1 = s * (_waist_edge_y(rib_x1) - 2.5);
        translate([0, 0, -base_t - 6])
            linear_extrude(height = 6 + 0.01)
                hull() {
                    translate([rib_x0, y0]) circle(d = 4);
                    translate([rib_x1, y1]) circle(d = 4);
                }
    }
}

// 육각 단부 장공 (헥스 벤트)
module _hex_slot2d(l, w) {
    hull()
        for (sx = [-1, 1])
            translate([sx * (l - w) / 2, 0])
                rotate(30) circle(d = w, $fn = 6);
}

// -----------------------------------------------------
// 1. 베이스 플레이트 (프린팅)
// -----------------------------------------------------
module base_plate() {
    tinted(c_stat)
    difference() {
        union() {
            // 본체: 도그본 플레이트, z -base_t..0
            translate([0, 0, -base_t])
                linear_extrude(height = base_t)
                    _base_outline2d();
            // 잭 스크류 블록: 모터 앞쪽(출력 풀리 쪽), 베이스 하면 아래
            // 모터 몸체가 베이스 아래 매달리므로 스크류도 같은 높이에 있어야 함
            // (베이스는 윗면을 베드에 대고 프린팅 → 블록이 서포트 없이 출력됨)
            translate([jack_block_x, 0, jack_z])
                cube(jack_block, center = true);
            // 베어링 보스 (하향, 잭 블록과 같은 방식으로 서포트 프리 출력)
            // 상부 608은 베이스 판 안, 하부 608은 보스 안 — 외륜 고정 하우징
            translate([0, 0, boss_z0])
                cylinder(d = boss_od, h = -base_t - boss_z0);
            // 웨이스트 보강 리브 (하면, C-채널 단면화) — 컴팩트는 웨이스트 없음
            if (!compact_base) _waist_ribs();
        }

        // 상부 608 포켓 Ø22.1 (베이스 윗면에서 압입, z -7..0)
        translate([0, 0, brgA_z0 - 0.01])
            cylinder(d = brg_od + 0.1, h = brg_w + 1);
        // 외륜 웹 내경 Ø20 (z -17..-7) — 내륜 스페이서 회전 간극,
        // 웹 상·하면이 외륜을 양방향 축하중에 대해 받친다
        translate([0, 0, spacer_z0 - 0.01])
            cylinder(d = 20, h = web_h + 0.02);
        // 하부 608 포켓 Ø22.1 (보스 하면에서 압입, z -24..-17 + 입구 여유)
        translate([0, 0, boss_z0 - 1])
            cylinder(d = brg_od + 0.1, h = (brgB_z0 + brg_w) - boss_z0 + 1.01);

        // 모터 체결 슬롯 4개 (모터축 기준 ±nema_hole_pitch/2)
        for (sx = [-1, 1], sy = [-1, 1])
            translate([-axis_dist + sx * nema_hole_pitch / 2,
                       sy * nema_hole_pitch / 2, -base_t - 1])
                linear_extrude(height = base_t + 2)
                    _slot2d_x(slot_w, slot_l);

        // 센터 보스 장공 (모터축 중심, 폭 y방향 boss_slot_w, x방향 길이 boss_slot_l)
        translate([-axis_dist, 0, -base_t - 1])
            linear_extrude(height = base_t + 2)
                _slot2d_x(boss_slot_w, boss_slot_l);

        // 잭 블록 M3 관통홀 (x방향, 블록 중앙 높이)
        translate([jack_block_x - jack_block[0] / 2 - 1, 0, jack_z])
            rotate([0, 90, 0])
                cylinder(d = 3.4, h = jack_block[0] + 2);

        // 육각 너트 포켓 (-x쪽 면 — 스크류가 모터를 -x로 밀면 너트가 블록 안쪽에 받쳐짐)
        translate([jack_block_x - jack_block[0] / 2 - 0.01, 0, jack_z])
            rotate([0, 90, 0])
                cylinder(d = 5.8 / cos(30), h = 2.6, $fn = 6);

        // 프레임 장착 M4 관통홀 4개
        for (p = mount_holes)
            translate([p[0], p[1], -base_t - 1])
                cylinder(d = mount_hole_d, h = base_t + 2);

        // 상면 패널라인 트렌치 (깊이 2, 폭 3.5 — 윤곽 인셋 띠)
        // 웨이스트 구간은 끊어 세그먼트화, 장착홀 주변은 키프아웃
        translate([0, 0, -2])
            linear_extrude(height = 3)
                difference() {
                    offset(delta = -3)   _base_poly2d();
                    offset(delta = -6.5) _base_poly2d();
                    if (!compact_base)
                        translate([-44, 0]) square([26, 44], center = true);
                    for (p = mount_holes) translate(p) circle(d = 13);
                }

        // 웨이스트 경사 헥스 벤트 2개 (관통) — 컴팩트는 자리가 없어 생략
        if (!compact_base)
            for (s = [-1, 1])
                translate([-46, s * 8.5, -base_t - 1])
                    linear_extrude(height = base_t + 2)
                        rotate(-s * 8) _hex_slot2d(14, 5);
    }
}

// -----------------------------------------------------
// 2. NEMA 17 모터 (베이스 아래 매달림)
// -----------------------------------------------------
module nema17() {
    // 몸체: 모서리 약간 깎인 정사각 단면 × nema_len
    tinted(c_motor)
    translate([-axis_dist, 0, -base_t - nema_len])
        linear_extrude(height = nema_len)
            offset(r = 2) offset(delta = -2)   // 모서리 R2
                intersection() {               // 코너 45도 컷
                    square(nema_side, center = true);
                    rotate(45) square(nema_side * 1.28, center = true);
                }

    // 위치결정 보스
    tinted(c_motor)
    translate([-axis_dist, 0, -base_t])
        cylinder(d = nema_boss_d, h = nema_boss_h);

    // 모터축 (축 길이 22mm → 베이스 윗면 기준 z 14까지) — 회전부
    tinted(c_move_m)
    translate([-axis_dist, 0, -base_t])
        cylinder(d = nema_shaft_d, h = nema_shaft_top + base_t);
}

// -----------------------------------------------------
// 3. GT2 20T 입력 풀리 (모터축 위, 보스 하향)
//    이빨부 z 8.9..16.5 — 벨트(9.7..15.7)와 정렬
//    상단이 축 끝(14) 위로 약간 돌출하나 풀리 강성으로 문제없음
// -----------------------------------------------------
module pulley20() {
    tinted(c_move_m)
    translate([-axis_dist, 0, 0])
        difference() {
            union() {
                // 세트스크류 보스 (아래)
                translate([0, 0, p20_z0])
                    cylinder(d = p20_boss_d, h = p20_boss_h);
                // 아래 플랜지
                translate([0, 0, p20_fl1_z0])
                    cylinder(d = p20_flange_d, h = 1.0);
                // 이빨부 (원통 단순화)
                translate([0, 0, p20_teeth_z0])
                    cylinder(d = p20_od, h = p20_teeth_h);
                // 위 플랜지
                translate([0, 0, p20_teeth_z0 + p20_teeth_h])
                    cylinder(d = p20_flange_d, h = 1.0);
            }
            // bore Ø5
            translate([0, 0, p20_z0 - 1])
                cylinder(d = 5, h = p20_z1 - p20_z0 + 2);
        }
}

// -----------------------------------------------------
// 4. 모터 체결 볼트 M3×12 + 대형와셔 4개
//    (베이스 8 + 와셔 1 통과 후 모터 탭에 약 3mm 체결)
// -----------------------------------------------------
module motor_bolts() {
    tinted(c_steel)
    for (sx = [-1, 1], sy = [-1, 1])
        translate([-axis_dist + sx * nema_hole_pitch / 2,
                   sy * nema_hole_pitch / 2, 0]) {
            // 대형 와셔 Ø9×1 (베이스 윗면)
            cylinder(d = 9, h = 1);
            // 볼트 머리 Ø5.5×3
            translate([0, 0, 1]) cylinder(d = 5.5, h = 3);
            // 축부 Ø3×12: 와셔+베이스 관통 → 모터 탭 3mm
            translate([0, 0, -base_t - 3]) cylinder(d = 3, h = base_t + 4);
        }
}

// -----------------------------------------------------
// 5. 잭 스크류 M3×20 + 너트
//    블록은 모터 앞(출력 쪽), 스크류 끝이 모터 앞면을 -x로 밀어 장력 인가
// -----------------------------------------------------
module jack_screw() {
    tip_x = -axis_dist + nema_side / 2;   // 모터 앞면(+x쪽) = 스크류 -x쪽 끝
    tinted(c_steel) {
        // 축부 Ø3×20 (x방향, 머리는 +x쪽 끝)
        translate([tip_x, 0, jack_z])
            rotate([0, 90, 0])
                cylinder(d = 3, h = 20);
        // 머리 Ø5.5 (+x쪽 끝)
        translate([tip_x + 20, 0, jack_z])
            rotate([0, 90, 0])
                cylinder(d = 5.5, h = 3);
        // 육각 너트 (블록 -x면 포켓 안, 폭간 5.5)
        translate([jack_block_x - jack_block[0] / 2 + 0.1, 0, jack_z])
            rotate([0, 90, 0])
                cylinder(d = 5.5 / cos(30), h = 2.4, $fn = 6);
    }
}

// -----------------------------------------------------
// 6. GT2-280 폐루프 벨트
// -----------------------------------------------------
module belt() {
    tinted(c_belt)
    translate([0, 0, belt_z0])
        linear_extrude(height = belt_w)
            difference() {
                offset(delta = belt_t) _belt_path2d();
                _belt_path2d();
            }
}

// 풀리 외경(단순화 원통)에 감기는 벨트 안쪽 윤곽 2D (컨벡스 헐)
module _belt_path2d() {
    hull() {
        circle(r = p60_od / 2);
        translate([-axis_dist, 0]) circle(r = p20_od / 2);
    }
}
