newro0209/timing_belt_joint_module/docs/assembly_labeled.png

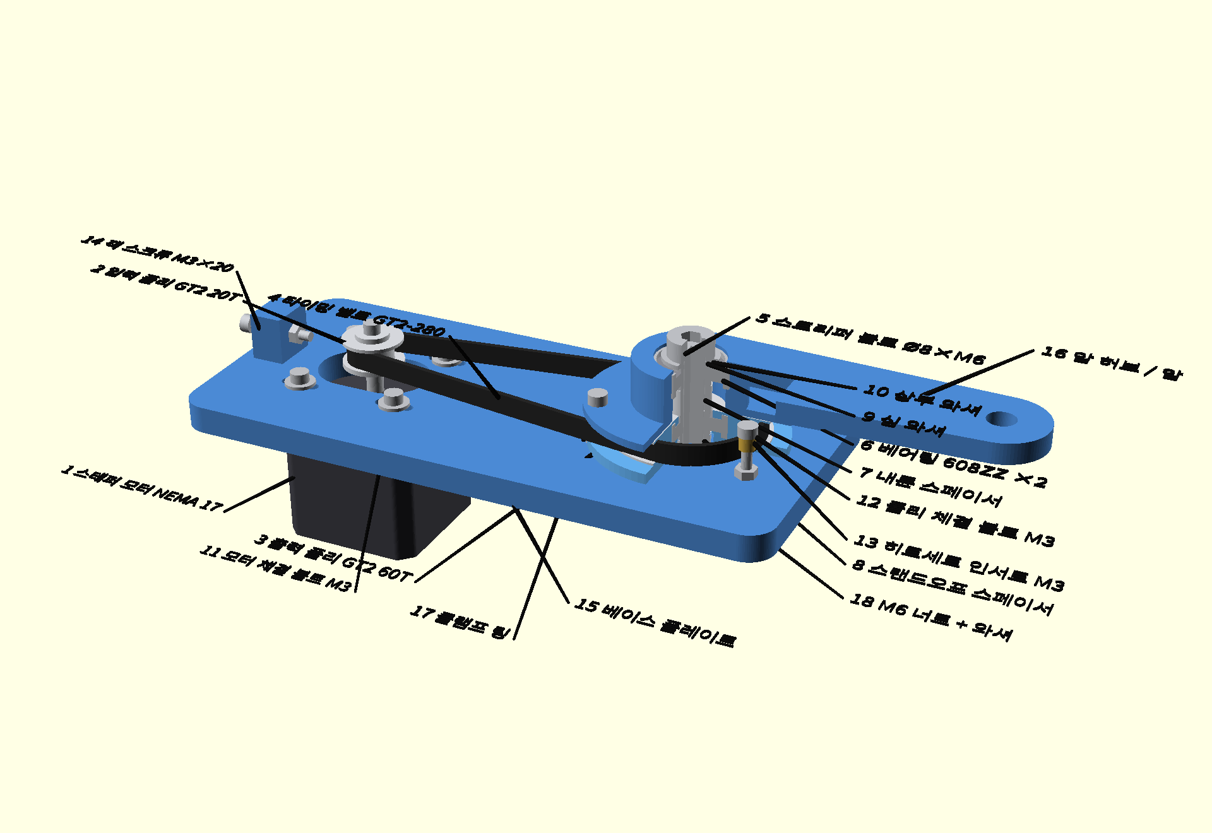
docs/assembly_labeled.png
