newro0209/timing_belt_joint_module/docs/views/print_layout.png

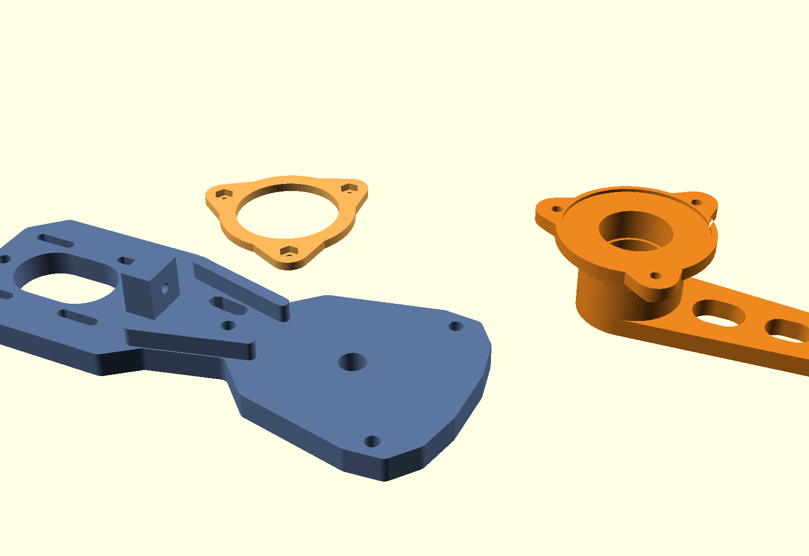
docs/views/print_layout.png
