newro0209/timing_belt_joint_module/(commit log)

2026-06-10 무가공 설계로 개선: 기성 부품 무가공 + 3D 프린팅 부품만 사용
    - 출력 풀리를 10mm bore로 변경해 Ø8 고정축과 클리어런스 확보 (확공 불필요)
    - 풀리 결합을 웹 드릴링 대신 프린팅 클램프 링 샌드위치 방식으로 변경
    - 암 허브에 Ø10 센터링 보스 일체 프린팅, 세트스크류는 보스만 물도록 지정
    - 베이스 M6 탭 제거, 관통홀 + 나일록 너트 체결로 통일
    - 잭 스크류 블록은 너트 포켓 몰드-인 방식으로 변경
    - 무가공 설계 원칙 절 추가, BOM에 클램프 링·M6 너트 추가
    https://claude.ai/code/session_01HUo3UWhaF2Ej2VLZj6x9Up
2026-06-10 OpenSCAD 조립 모델 추가 — BOM 18품목 한글 라벨 표기
    - scad/params.scad: 공통 치수·좌표 규약 (축간거리 99.2, 적층 z좌표)
    - scad/motor_side.scad: 베이스 플레이트(슬롯·장공·잭 블록 일체), NEMA17,
    GT2 20T 풀리, 모터 볼트, 잭 스크류, 폐루프 벨트
    - scad/output_side.scad: 스트리퍼 볼트, 608ZZ ×2, 스페이서류, 와셔류,
    암 허브(센터링 보스·클램프 플랜지), GT2 60T, 클램프 링, 체결 볼트,
    히트세트 인서트, M6 너트
    - scad/assembly.scad: 전체 조립 + 부품별 1/4 단면 컷어웨이 +
    DESIGN.md 6장 부품 번호 한글 라벨(지시선 + 빌보드 텍스트)
    - docs/assembly_labeled.pn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
    [assembly.scad, motor_side.scad, output_side.scad, params.scad]
2026-06-10 기계 검증 후 설계 수정: 조립 가능성 확보 + 기성품 표준화
    검증에서 발견된 조립 불가 수준 문제 12건 수정 (DESIGN.md 부록 참조):
    - 쇼울더볼트 나사부 10mm 한계 → 머리 하향 + 상단 M6 나일록 체결로 반전
    - 상부 베어링 보어 양측 폐쇄 → 윗면 개방, 압입 방향 명기
    - 실물 GT2 60T 보스(Ø32x6.5) 미반영/허브 간섭 → 보스 하향 배치, 적층 재설계
    - 벽 0.7mm 센터링 보스 → Ø44.6 플랜지 받이 포켓, bore 10→12mm
    - 잭 스크류 방향 반대 + 모터와 높이 불일치 → 모터 앞 베이스 하면으로 이동
    - 모터 볼트 M3x8 체결 길이 부족 → M3x12
    - 히트세트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
    [assembly.scad, motor_side.scad, output_side.scad, params.scad]
2026-06-10 조립도 라벨 가독성 개선: 좌우 칼럼 정렬·등간격 배치, 모터에 겹치던 라벨 이동
    https://claude.ai/code/session_014RXXExQczonAJzcw2caz8Y
    [assembly.scad]
2026-06-10 소재 절약 형상 최적화: 도그본 베이스·트러스 암·3-로브 플랜지/링 (-37%, 138→87cm³)
    - 베이스: 직사각 통판 → 모터 패드 + 빔 + 출력 디스크 + 장착 귀 (-42%)
    - 암: 끝단 테이퍼(32→18) + 관통 트러스 컷 3개 (-22%)
    - 허브 플랜지·클램프 링: 3-로브 스캘럽 (-31%)
    - 전부 2.5D 윤곽 유지 → 추후 CNC 판재 가공에 동일 도형 재사용 가능
    - scad/print_parts.scad 추가 (단품 STL 내보내기, 권장 출력 방향 반영)
    - docs/views/ 다각도 렌더 추가
    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
    [assembly.scad, motor_side.scad, output_side.scad, params.scad, print_parts.scad]
2026-06-10 베이스 플레이트 메카닉 스타일링: 패싯 윤곽 + 패널라인 트렌치 + 헥스 벤트
    - 둥근 도그본 → 45° 챔퍼 모터 패드 / 테이퍼 웨이스트 / 출력 패싯 / 스웹트 윙
    - 상면 패널라인 트렌치(깊이 2, 폭 3.5), 웨이스트 관통 헥스 벤트 2개
    - 2.5D 윤곽·포켓만 사용 → CNC 호환 유지, 부피 58.9cm³ (전체 -37% 유지)
    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
    [assembly.scad, motor_side.scad, params.scad]
2026-06-10 웨이스트 보강: 하면 에지 리브(C-채널 단면화) + 오목 코너 R3 필렛
    - 웨이스트 양 가장자리에 4x6mm 리브 — 면외 굽힘 강성 확보, 서포트 불필요
    - 윤곽 오목 꼭짓점 응력 집중 완화 (R3)
    - CNC(알루미늄) 가공 시 리브 생략 가능 명기, 부피 60.7cm³
    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
    [motor_side.scad]
2026-06-10 서포트 프리 출력 형상: 허브 플랜지 단차 지붕 + 볼트 헤드 카운터보어
    - 플랜지 하향 평면(뒤집어 출력 시 유일한 서포트 요구부)을 1.3mm 단차 6단 지붕으로 대체
    - 클램프 볼트 머리는 지붕 관통 Ø6.5 카운터보어에 안착, 수직 드라이버 접근 유지
    - 베이스/링은 기존 방향에서 이미 서포트 불필요(브리지·꼭짓점-업 육각 포켓)
    - 부피 92.8cm³ (-33%), print_parts.scad 출력 방향 주석 갱신
    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
    [output_side.scad, print_parts.scad]
2026-06-10 회전부/고정부 색 구분: 주황(회전) vs 블루·그레이(고정)
    - 회전: 암 허브, 출력/입력 풀리, 클램프 링·볼트, 베어링 외륜·실드, 모터 축
    - 고정: 베이스, 스트리퍼 볼트, 스페이서·와셔, 베어링 내륜, 너트, 모터
    - 베어링 내·외륜을 다른 색으로 분리해 고정 적층/회전부 경계를 시각화
    - DESIGN.md 색 규약 추가, 전체 뷰 렌더 갱신
    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
    [assembly.scad, motor_side.scad, output_side.scad, params.scad]
2026-06-10 축 계통 3변형 구조화: shoulder(현행)/collar(연마봉+칼라)/printed(M8+프린팅 슬리브)
    - params.scad: axle 파라미터로 변형 전환 (-D 'axle="collar"' 등)
    - 옵션2: Ø8 연마봉 L70 + 샤프트 칼라 2개 — 심·너트·와셔 삭제, 무단 예압
    - 옵션5: M8x70 부분나사 + 프린팅 슬리브 2종 — 금속 스페이서 0, bore14 풀리
    - 베어링·허브·풀리·클램프·베이스는 3변형 완전 공유
    - assembly 라벨 변형별 분기, print_parts에 part="sleeves" 추가
    - DESIGN.md 변형 비교표 + 렌더 명령 추가, docs/views/axle_*.png
    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
    [assembly.scad, output_side.scad, params.scad, print_parts.scad]
2026-06-10 축 계통 톤온톤 + 1/4 단면을 반투명 고스트로 변경
    - 축 계통 색 세분: 너트/칼라(진회색) < 축(중회색) < 내륜 < 스페이서 < 와셔(밝음), 심=청회색
    - tinted() 헬퍼 + $ghost_alpha 동적 전파로 부품 내부 색을 투명도와 함께 적용
    - cutaway(): 1/4 절단 대신 불투명 3/4 + 반투명 1/4 고스트, 부품별 투명도 차등
    - 변형 3종 렌더 갱신
    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
    [assembly.scad, motor_side.scad, output_side.scad, params.scad]
2026-06-10 축 변형 분기 제거 + 심 와셔 폐지: 허브 13mm 증육, 위치별 평와셔 선정
    - collar/printed 변형 삭제 — shoulder(스트리퍼 볼트) 단일 구조로 확정
    - 심 와셔 폐지: 심(Ø14)이 프린팅 허브를 파고드는 면압 집중 + 직렬
    적층이라 예압 조정 기능도 없음 (부록 #15)
    - 허브 12→13mm: 적층 55.9 > 쇼울더 55 — 수지 +0.9mm를 형상으로 보장
    - 평와셔 위치별 확정: 머리측·중간 M8×15×1.6, 상부 M6×22×2.0 광폭
    (허브 면압 약 30→9MPa, M6 나사부 구간이라 내경 6.4로 센터링)
    - 조립 라벨 정비: #10 와셔 3개 개별 지시, #13 M3 육각 너트 추가,
    좌측 칼럼 텍스트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
    [assembly.scad, motor_side.scad, output_side.scad, params.scad, print_parts.scad]
2026-06-10 벨트 길이 파라미터화 + GT2-200 컴팩트 버전: belt_len으로 축간거리 역산
    - 커스터마이저 정리: /* [그룹] */ + 파라미터별 설명 주석, 파생 치수는
    [Hidden] 분리, print_parts part 드롭다운, ghost_alpha 위치 수정
    - belt_len(200/260/280/300) → C 자동 역산 (280→99.2, 200→58.6)
    - 컴팩트 베이스(C<81): 웨이스트 생략·패드-윙 직결 윤곽, 장착홀 3점,
    리브·헥스 벤트 제외
    - 모터 측 라벨 앵커를 axis_dist 상대좌표로, 벨트 라벨 동적 표기
    - GT2-150 불성립 기록: 필요 C 32.5 < 최소 C 37.2 (모터 몸체↔보스 간섭)
    [assembly.scad, motor_side.scad, params.scad, print_parts.scad]
